riaaazul78/A-bridge-circuit-converting-resistance-change-of-thermistor-into-voltage-change/4eqns.PNG

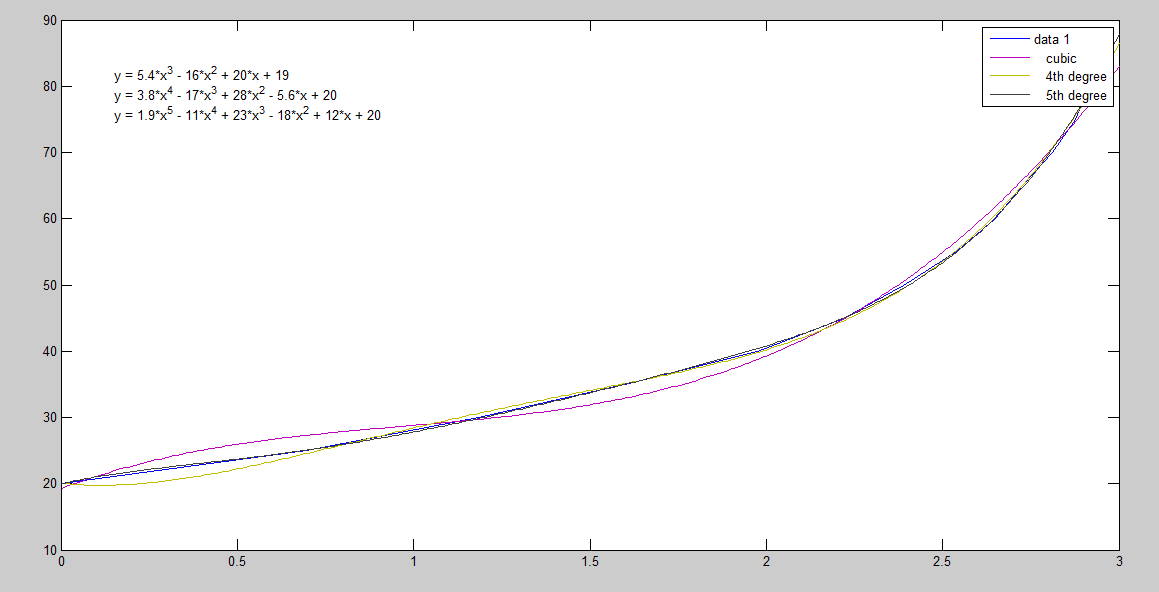
4eqns.PNG
