riaaazul78/A-bridge-circuit-converting-resistance-change-of-thermistor-into-voltage-change/Schematic Circuit Diagram.jpg

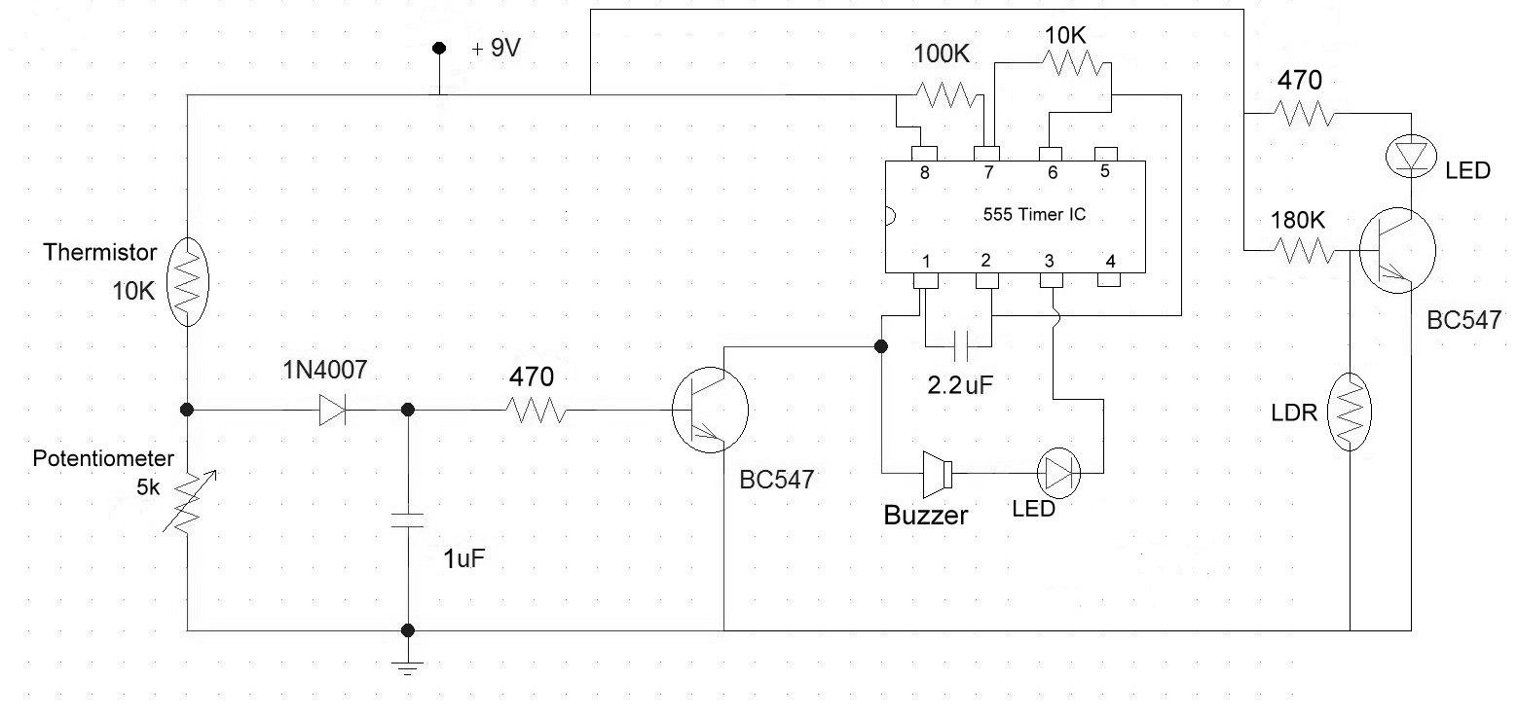
Schematic Circuit Diagram.jpg
